shaxntanu/QUARK/docs/AI_SKILLS_REFERENCE.md

# AI skills and tool reference

This registry records the skills and specialized repositories named by the repository audit prompt, plus the tools actually used. A reference in the prompt does not mean that a skill was installed or used. Repository metadata was checked on 2026-11-02 where a source could be resolved.

| Skill or tool | Repository or source | Purpose and trigger | Availability and use in QUARK | Generated artifact, validation, or note |
|---|---|---|---|---|
| Anatomy | [wheresryan22/anatomy](https://github.com/wheresryan22/anatomy) | Build a spatial illustration when physical component relationships benefit from an isometric explanation. | Anatomy skill available in the Codex skill catalog; used for the existing system illustration. | `docs/anatomy/quark-system.svg`; XML parsed and links checked. It is not a PCB render. |
| Diagram Design | [cathrynlavery/diagram-design](https://github.com/cathrynlavery/diagram-design) | Create specialized diagrams when Mermaid or an existing figure does not communicate the structure well. | Skill available in the Codex catalog; no new diagram created in this audit because the existing Mermaid architecture and Anatomy figure cover the current system. | No new artifact. Repository relevance was reviewed; see [hardware workflow notes](research-notes.md). |
| Mermaid | [Mermaid documentation](https://mermaid.js.org/) | Describe small architecture and protocol diagrams as text when that is the simplest representation. | Used in `docs/architecture.md`; GitHub renders it. No separate Mermaid package is installed in the project. | Existing diagram retained; no duplicate diagram was created. |
| Taste Skill | [Leonxlnx/taste-skill](https://github.com/Leonxlnx/taste-skill) | Improve the visual quality of web interfaces and frontend layouts. | Upstream repository referenced. Local `design-taste-frontend` skill is available, but was not needed for this firmware and documentation work. | No frontend output. Not applicable to the repository's user-facing surface in this audit. |
| ManimGX | [academa-labs/manimgx](https://github.com/academa-labs/manimgx) and [documentation index](https://manimgx.academa.ai/llms.txt) | Create explanatory animation when change over time or motion is central to the explanation. | Not installed or used. A static system figure and Mermaid diagram are sufficient for this local hardware system. | No video or new dependency. |
| good-readme | [adewale/good-readme](https://github.com/adewale/good-readme) | Review project README structure and completeness. | Referenced by the prompt; not installed as a local skill or invoked directly. The repository README was reviewed and edited against repository evidence. | README is the artifact. The canonical verification command is documented there. |
| readme-writing | Prompt reference: `indubitably-ai/readme-writing` | Improve README composition and open-source navigation. | Repository lookup returned 404 on 2026-11-02. No official repository URL was verified and none is invented here. | Not installed or used. |
| JayRHa readme-generator | [JayRHa/agent-skills](https://github.com/JayRHa/agent-skills), skill name `readme-generator` | Draft README sections and project navigation when creating or revising a repository README. | Referenced by the prompt; not installed or invoked directly. | README edited from source and project evidence. |
| JayRHa technical-writer | [JayRHa/agent-skills](https://github.com/JayRHa/agent-skills), skill name `technical-writer` | Improve developer documentation and technical explanations. | Referenced by the prompt; not installed or invoked directly. | Documentation is checked for internal links and selected text policy. |
| riekelt technical-writer | [riekelt/technical-writer](https://github.com/riekelt/technical-writer) | Ground technical statements in repository evidence and label uncertainty. | Referenced by the prompt; not installed or invoked directly. | Applied as a documentation quality criterion, not as an installed tool. |
| Shpigford readme | Prompt reference: `Shpigford/readme` | Comprehensive README review. | Repository lookup returned 404 on 2026-11-02. No official repository URL was verified and none is invented here. | Not installed or used. |
| matt-riley writing-and-editing | Prompt reference: `matt-riley/writing-and-editing` | Editorial review for grammar and consistency. | Repository lookup returned 404 on 2026-11-02. No official repository URL was verified and none is invented here. | Not installed or used. |
| GitHub profile README | [boffti/github-profile-readme](https://github.com/boffti/github-profile-readme) | Conventions for a personal GitHub profile README. | Repository URL verified. Not applicable because QUARK is a project repository. | No artifact. |
| KiCad Happy | [aklofas/kicad-happy](https://github.com/aklofas/kicad-happy) | Reference for agent-assisted KiCad workflows. | Reviewed through Crawl4AI; not installed or copied into the project. | Findings summarized in [research notes](research-notes.md). |
| AI PCB Layout | [ChengminLi/AI-PCB-layout](https://github.com/ChengminLi/AI-PCB-layout) | Reference for PCB layout analysis in power-electronics contexts. | Reviewed through Crawl4AI; high-power switching practices were not applied to this low-speed carrier. | No new layout or thermal claim. See [research notes](research-notes.md). |
| KiCad MCP Pro | [oaslananka/kicad-mcp-pro](https://github.com/oaslananka/kicad-mcp-pro) | Reference for KiCad automation and CAD verification workflows. | Repository reviewed; no MCP server installed or used. | Native KiCad CLI results remain the CAD evidence. |
| KiStack | [BackplaneWorks/kistack](https://github.com/BackplaneWorks/kistack) | Reference for staged schematic, PCB, BOM, and manufacturing review. | The prompt URL redirects to this canonical repository. Reviewed through Crawl4AI; no source copied. | Existing outputs were inventoried; no new fabrication exports were created. |
| Circuit Skills | [punkfab/circuit-skills](https://github.com/punkfab/circuit-skills) | Reference for hardware-specific design checks beyond ERC and DRC. | Reviewed through Crawl4AI; not installed or copied. | No measured electrical claim was added. |
| Crawl4AI | [unclecode/crawl4ai](https://github.com/unclecode/crawl4ai) | Retrieve web pages for evidence-based engineering research. | Version 0.9.5 used from a temporary environment, not as a project dependency. Firecrawl was not used. | Source retrieval notes are in [research sources](research-sources.md). Some pages and a PDF timed out or returned anti-bot responses. |
| KiCad CLI | [KiCad CLI manual](https://docs.kicad.org/10.0/en/cli/cli.html) | Run schematic ERC and PCB DRC when KiCad source is changed or re-audited. | Version 10.0.7 was used for recorded CAD checks. | Results and ignored checks are in [verification](verification.md). |
| Arduino CLI | [Arduino CLI repository](https://github.com/arduino/arduino-cli) | Compile the ESP32-C3 sketch from a repeatable command or CI. | Version 1.5.1 used in hosted CI; not found on the local command path during this audit. | Firmware job compiles the `esp32:esp32:esp32c3:CDCOnBoot=cdc` target. |
| U8g2 | [U8g2 repository](https://github.com/olikraus/u8g2) | Drive the configured SH1106 128x64 OLED. | Version 2.36.19 installed in hosted firmware CI. | Compile-verified; exact OLED module remains unknown and hardware-unverified. |
| OpenAI documentation skill | Codex built-in skill `openai-docs`; [App Server docs](https://learn.chatgpt.com/docs/app-server) | Read current official OpenAI documentation for the Codex App Server interface. | Available in the Codex skill catalog and used to review the official interface documentation. | Source and constraints recorded in [research sources](research-sources.md). |
| Visualization skill | Codex built-in skill `visualize` | Create interactive visualizations when they materially improve understanding. | Available in the Codex skill catalog; not used because the hardware architecture is sufficiently covered by Mermaid and the static Anatomy figure. | No extra visualization artifact. |

Repository lookup failures are recorded as such. A skill being listed here is not a dependency, endorsement, or claim that its output was independently validated.

## Token-efficient agent stack

These five projects were supplied in the follow-up workflow prompt. Their GitHub repository URLs were checked through the GitHub API on 2026-11-02. No project was installed, configured, or integrated, so its installation instructions were not used. No measurable token or cost reduction is claimed.

| Project | Official repository | Availability in this agent session | Applied fallback |
|---|---|---|---|
| Ponytail | [DietrichGebert/ponytail](https://github.com/DietrichGebert/ponytail) | No matching active tool or command found. | Applied its minimal-solution review manually. No further code or dependencies were added after the audit passed. |
| Lean Coding Agent | [JeremyFaubert/lean-coding-agent-skill](https://github.com/JeremyFaubert/lean-coding-agent-skill) | No matching active skill or command found. | Used targeted file ranges, bounded outputs, and risk-based validation. |
| Serena | [oraios/serena](https://github.com/oraios/serena) | No Serena MCP tool or command found. | Used native exact search, Git diffs, and direct reads of relevant files. |
| skill-search | [sowhan/skill-search](https://github.com/sowhan/skill-search) | No matching active skill or command found. | Used the native skill catalog and loaded no unrelated skill descriptions. |
| Token Optimizer MCP | [ooples/token-optimizer-mcp](https://github.com/ooples/token-optimizer-mcp) | No matching active MCP tool found. | Bounded tool output and summarized relevant results. No large log or API payload required compression. |

The fallback policies come from the supplied prompt. They were applied without copying upstream code or installing new tooling into QUARK.
