shaxntanu/QUARK/docs/generated-artifacts.md

# Generated artifact provenance

This inventory records important checked-in outputs and the current Windows package build. It does not claim bit-for-bit reproducibility where the generator or export command is not deterministic or recorded.

| Artifact | Source or generator | Inputs | Generation method and tool | Validation and limitation |
|---|---|---|---|---|
| [System illustration](anatomy/quark-system.svg) | Anatomy skill, with repository architecture and hardware documentation as inputs | Current host, USB, controller, display, and control relationships | Static SVG was created for the audit. No standalone source generator or exact skill version is recorded. | XML parsed successfully and the image is linked from the README and architecture page. It is explanatory, not to scale or an assembly drawing. |
| ESP32-C3 firmware binary | `QUARK.ino` and installed Arduino packages | ESP32-C3 target and CDC-on-boot option | Arduino CLI 1.5.1, ESP32 core 3.3.10, U8g2 2.36.19; command in the README and CI workflow | CI compiles the source. The checked-in merged image and a previous local merged image had different SHA-256 values; the cause is not known. Do not treat them as identical builds. |
| KiCad schematic and PCB | `hardware/QUARK_SuperMini_Carrier/scripts/generate_schematic.py` and `generate_board.py` | Python generators, `pcbnew`, project-local symbols and footprints | Run each source generator in the KiCad Python environment. The board generator uses random UUIDs, so byte-for-byte regeneration is not deterministic. | Checked-in design was checked with KiCad CLI 10.0.7. Review the generated diff and ignored ERC/DRC checks before fabrication. |
| Gerbers, drill files, maps, and archive | KiCad project outputs under `hardware/QUARK_SuperMini_Carrier/fabrication/` | Checked-in schematic and PCB | The exact export command and KiCad export profile were not recorded. | Files are present and referenced by the hardware README. No fabricator inspection or board assembly is claimed. |
| BOM CSV | `hardware/QUARK_SuperMini_Carrier/BOM.csv` | Manually maintained board and off-board parts list | Edited as a project text file; no BOM export command is recorded. | Parts are mostly generic and exact MPNs are missing. See [hardware references](hardware-references.md). |
| KiCad preview PNGs and schematic PDF | KiCad project outputs in the `preview/` folder and carrier directory | Checked-in schematic and board | Exact export commands and tool versions for these files were not retained. | Existing outputs were inventoried; they are not new evidence of fabrication quality. |
| Windows executable | `quark.py`, `requirements.txt`, `requirements-build.txt`, `scripts/build_exe.ps1` | Python 3.12.10 Windows environment | `py -3.12 -m PyInstaller` through `scripts/build_exe.ps1`, PyInstaller 6.22.3 | Built successfully on 2026-11-02 at 9,840,202 bytes. `dist/QUARK.exe` is ignored and not committed. The build was not launched in a separate session. |

The Mermaid diagram in `architecture.md` is source text rendered by GitHub and is not a separately generated binary. Crawl4AI output was used only as research input and is not shipped with QUARK.
