shaxntanu/QUARK/docs/research-sources.md

# Research sources

This ledger records external sources that materially informed interface, tooling, and maintenance decisions. It does not claim that every cited reference was used to design an electrical limit or certify a standard.

| Source | URL | Type and authority | Version or date | Claim or decision supported | Notes |
|---|---|---|---|---|---|
| Codex App Server documentation | [OpenAI documentation](https://learn.chatgpt.com/docs/app-server) | Official product documentation | Accessed 2026-11-02 | The companion uses the local App Server JSON-RPC interface. The response reader now queues response messages and ignores unsolicited methods that it does not consume. | The interface and authentication guidance can change. This documents the local open-source companion, not a hosted service. No live account session was tested. |
| KiCad Command Line Interface manual | [KiCad 10 CLI manual](https://docs.kicad.org/10.0/en/cli/cli.html) | Official KiCad documentation | KiCad 10; checks used 10.0.7 | Documents the ERC and DRC commands used to check the supplied schematic and board. | The reports list ignored checks. See [verification](verification.md). |
| GitHub Actions secure use | [GitHub security guidance](https://docs.github.com/en/actions/reference/security/secure-use) | Official GitHub documentation | Accessed 2026-11-02 | Supports least-privilege workflow permissions and review of third-party actions. The workflow actions are pinned to immutable commit SHAs. | Guidance does not by itself establish that a pinned action is safe. Updates still need review. |
| GitHub Actions used by CI | [checkout source at the pinned commit](https://github.com/actions/checkout/tree/3d3c42e5aac5ba805825da76410c181273ba90b1), [setup-python source at the pinned commit](https://github.com/actions/setup-python/tree/6d4fd22b20465ccc0f7354476588e8df7c9ca0e0), [Arduino CLI setup source at the pinned commit](https://github.com/arduino/setup-arduino-cli/tree/81d310742121c928ea9c8bbd407b4217b432ae02) | Upstream source repositories and immutable revisions | Refs resolved from upstream release tags on 2026-11-02 | Establishes the exact action revisions used by the workflow. | Pinning prevents a tag move from silently changing workflow code; it does not replace action review. |
| Arduino ESP32 core release | [arduino-esp32 3.3.10 release](https://github.com/espressif/arduino-esp32/releases/tag/3.3.10) | Official upstream release record | 3.3.10 | Records the Arduino ESP32 core version selected by CI. | The release record is not a substitute for the compiler output in CI. |
| ESP32-C3 datasheet | [Espressif ESP32-C3 datasheet](https://documentation.espressif.com/esp32-c3_datasheet_en.pdf) | Official manufacturer document | Current document URL checked 2026-11-02 | Candidate primary reference for the ESP32-C3 SoC family. | Crawl4AI could not retrieve the PDF body during this audit. No numeric electrical constraint in this repository was newly justified from that document. The carrier uses a module, not a bare SoC. |
| Hardware workflow repositories | [Research notes](research-notes.md) | Maintainer-authored repositories, secondary engineering references | Crawled 2026-11-02 | Informed a proportionate review of existing KiCad source, BOM, fabrication exports, and ignored CAD checks. | These repositories were not installed as dependencies and their generators were not copied. |
| Crawl4AI | [Crawl4AI repository](https://github.com/unclecode/crawl4ai) | Open-source crawling tool | 0.9.5 in a temporary research environment | Used to retrieve selected project and official documentation pages for this audit. | GitHub raw pages and a vendor PDF timed out or triggered anti-bot behavior. Only successfully retrieved content informed the review. Crawl4AI is not a QUARK runtime or build dependency. |

## Retrieval notes

The Codex App Server guide was reviewed with the OpenAI documentation skill. Crawl4AI 0.9.5 was used for source retrieval, including the KiCad and hardware workflow review recorded in [research-notes.md](research-notes.md). The official KiCad manual, GitHub Actions security page, Arduino ESP32 release page, and selected GitHub repository metadata were reachable. Some GitHub raw pages and the Espressif PDF body could not be retrieved through Crawl4AI because of timeouts or anti-bot responses. The datasheet URL itself was reachable, but its contents were not treated as reviewed evidence.

## Research boundary

No academic novelty, comparative effectiveness, electrical certification, performance benchmark, or SDG impact claim is made. No external source was used to infer the exact manufacturer or revision of the SuperMini clone, OLED module, LEDs, piezo, or other generic BOM parts.
