shaxntanu/QUARK/hardware/QUARK_SuperMini_Carrier/preview/board_bottom.png

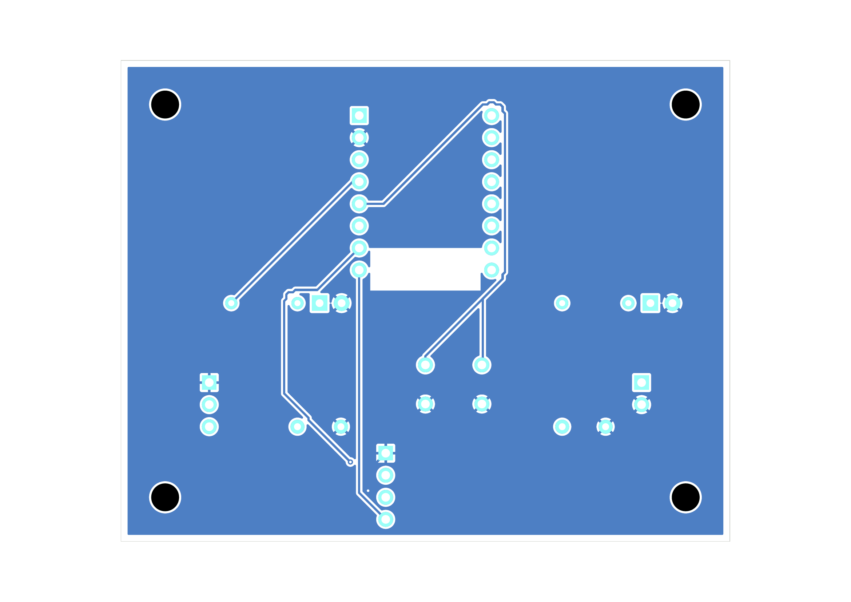
hardware/QUARK_SuperMini_Carrier/preview/board_bottom.png
