shaxntanu/QUARK/hardware/QUARK_SuperMini_Carrier/preview/board_top.png

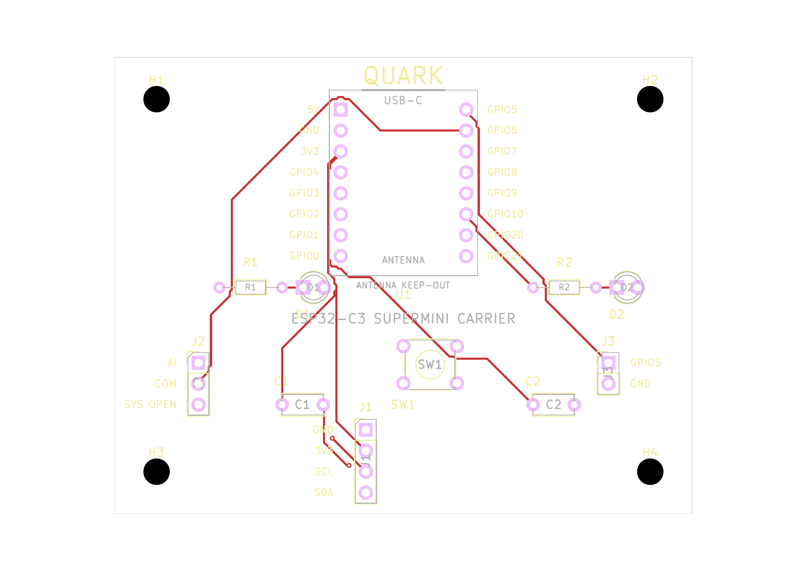
hardware/QUARK_SuperMini_Carrier/preview/board_top.png
