shaxntanu/QUARK/hardware/QUARK_SuperMini_Carrier/preview/schematic.png

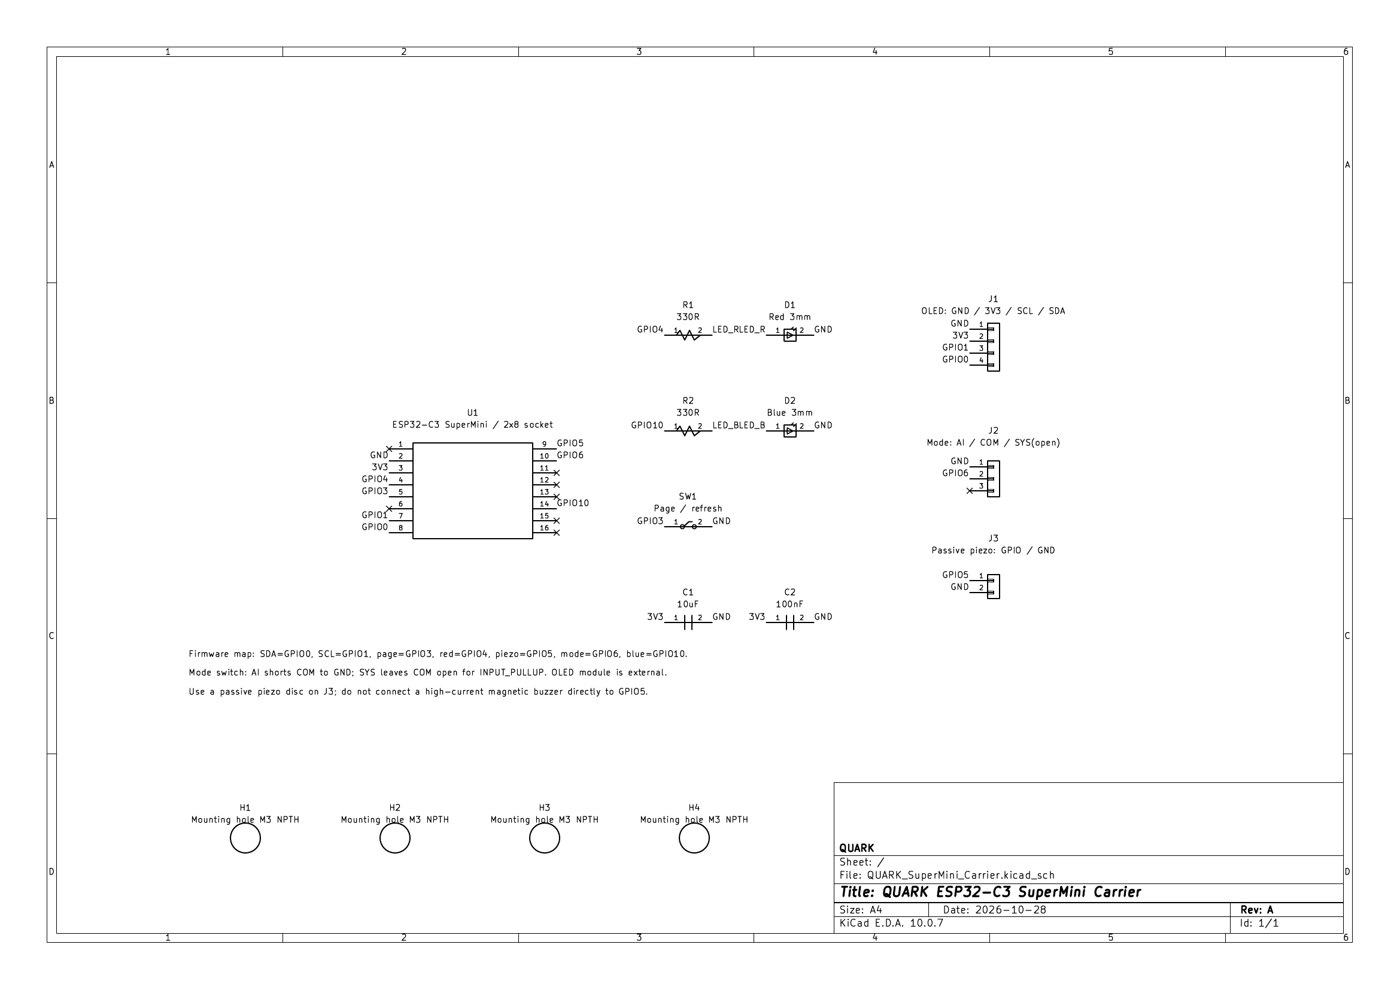
hardware/QUARK_SuperMini_Carrier/preview/schematic.png
