shaxntanu/QUARK/hardware/QUARK_SuperMini_Carrier/QUARK_SuperMini_Carrier_Schematic.pdf

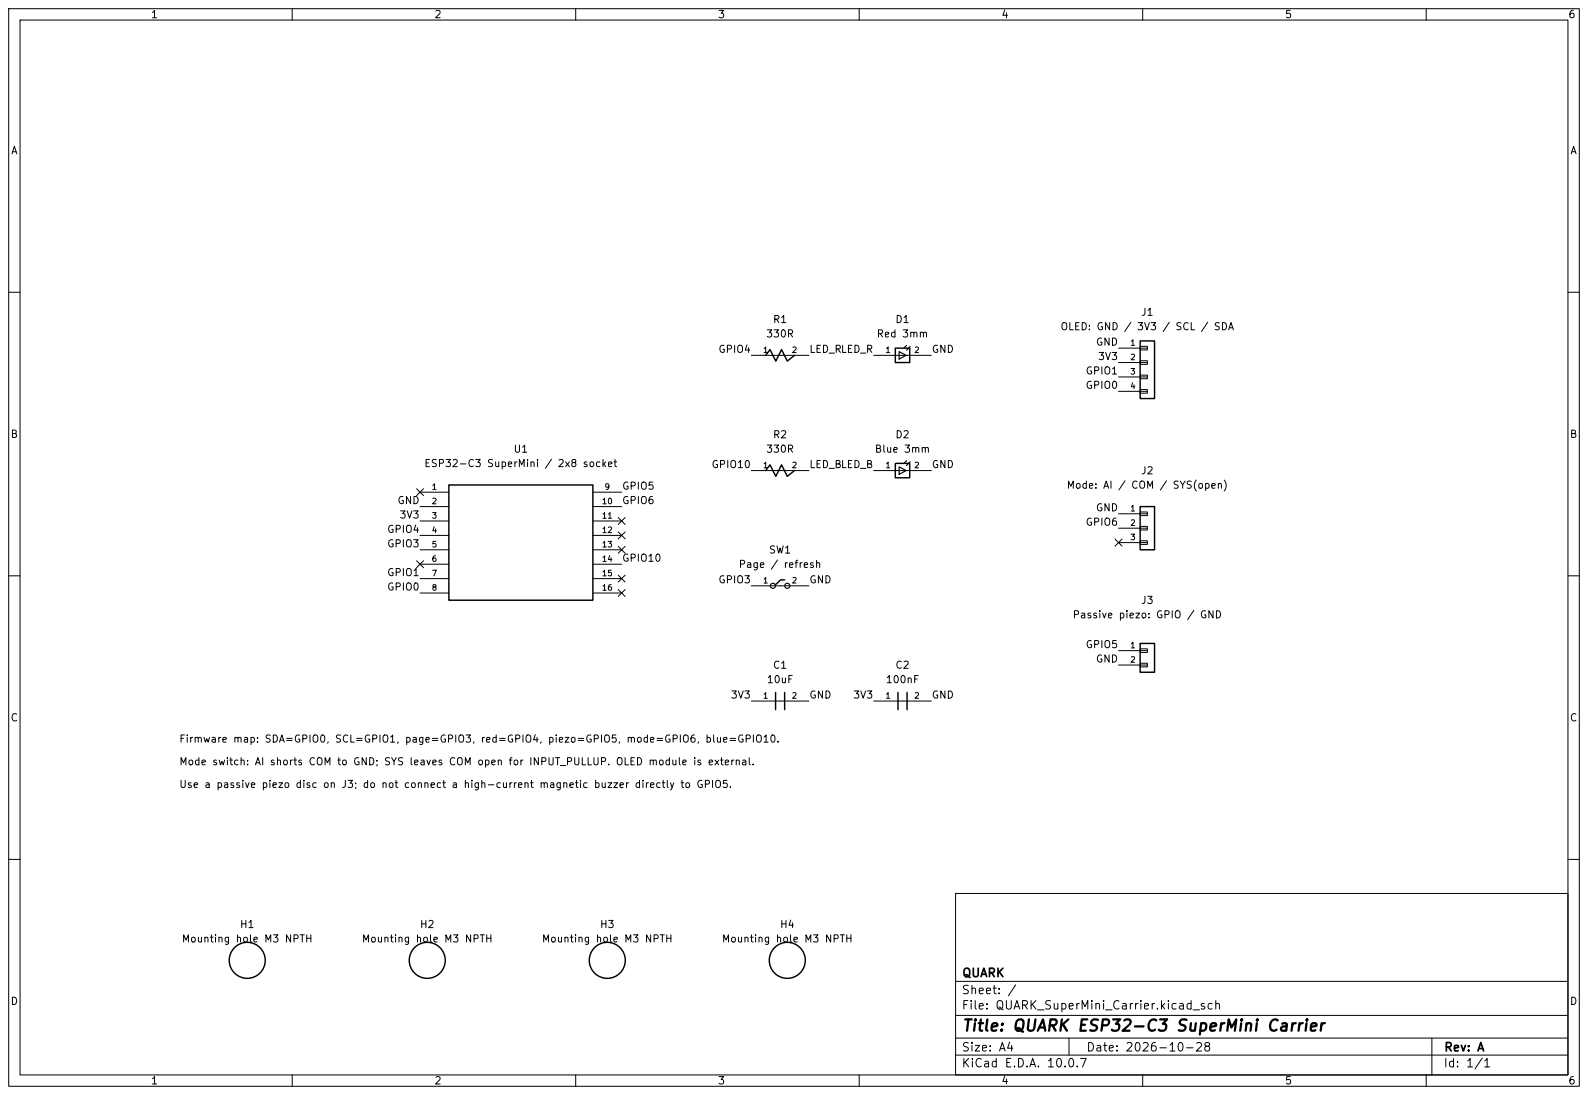
[picture p4: page 1]

4 J1 OLED: GND / 3V3 / SCL / SDA

GPIO4 Use a passive piezo disc on J3; do not connect a high-current magnetic buzzer directly to GPIO5. Firmware map: SDA=GPIO0, SCL=GPIO1, page=GPIO3, red=GPIO4, piezo=GPIO5, mode=GPIO6, blue=GPIO10. Mode switch: AI shorts COM to GND; SYS leaves COM open for INPUT_PULLUP. OLED module is external.

2 J3 Passive piezo: GPIO / GND

Size: A4 | Rev: A
KiCad E.D.A. 10.0.7 | Id: 1/1
