shaxntanu/QUARK/hardware/QUARK_SuperMini_Carrier/QUARK_SuperMini_Carrier.kicad_pcb

## KiCad design hardware/QUARK_SuperMini_Carrier/QUARK_SuperMini_Carrier.kicad_pcb (2026-10-28)

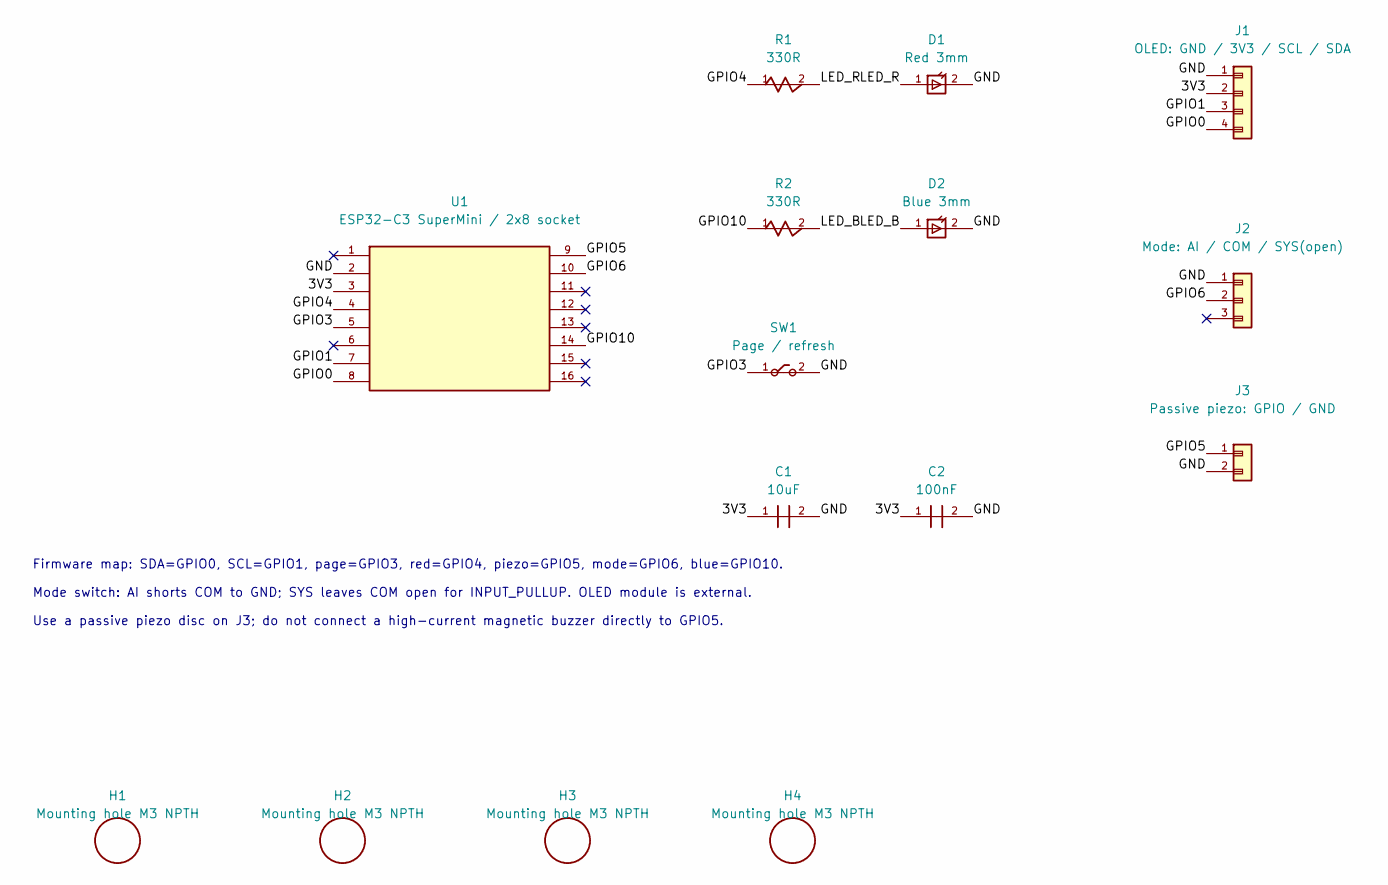
[picture p5: schematic QUARK_SuperMini_Carrier.kicad_sch, QUARK ESP32-C3 SuperMini Carrier]

Parts:
C1: 10uF; C_Disc_D5.0mm_W2.5mm_P5.00mm
C2: 100nF; C_Disc_D5.0mm_W2.5mm_P5.00mm
D1: Red 3mm; LED_D3.0mm
D2: Blue 3mm; LED_D3.0mm
H1, H2, H3, H4: Mounting hole M3 NPTH; MountingHole_3.2mm_M3
J1: OLED: GND / 3V3 / SCL / SDA; PinHeader_1x04_P2.54mm_Vertical
J2: Mode: AI / COM / SYS(open); PinHeader_1x03_P2.54mm_Vertical
J3: Passive piezo: GPIO / GND; PinHeader_1x02_P2.54mm_Vertical
R1, R2: 330R; R_Axial_DIN0204_L3.6mm_D1.6mm_P7.62mm_Horizontal
SW1: Page / refresh; SW_TH_Tactile_Omron_B3F-100x
U1: ESP32-C3 SuperMini / 2x8 socket; ESP32C3_SuperMini_Socket_2x8

Connections:
/3V3: C1.1, C2.1, J1.2, U1.3 (3V3)
/GND: C1.2, C2.2, D1.2 (K), D2.2 (K), J1.1, J2.1, J3.2, SW1.2, U1.2 (GND)
/GPIO0: J1.4, U1.8 (GPIO0)
/GPIO1: J1.3, U1.7 (GPIO1)
/GPIO3: SW1.1, U1.5 (GPIO3)
/GPIO4: R1.1, U1.4 (GPIO4)
/GPIO5: J3.1, U1.9 (GPIO5)
/GPIO6: J2.2, U1.10 (GPIO6)
/GPIO10: R2.1, U1.14 (GPIO10)
/LED_B: D2.1 (A), R2.2
/LED_R: D1.1 (A), R1.2

Notes on the sheet:
Firmware map: SDA=GPIO0, SCL=GPIO1, page=GPIO3, red=GPIO4, piezo=GPIO5, mode=GPIO6, blue=GPIO10.
Mode switch: AI shorts COM to GND; SYS leaves COM open for INPUT_PULLUP. OLED module is external.
Use a passive piezo disc on J3; do not connect a high-current magnetic buzzer directly to GPIO5.

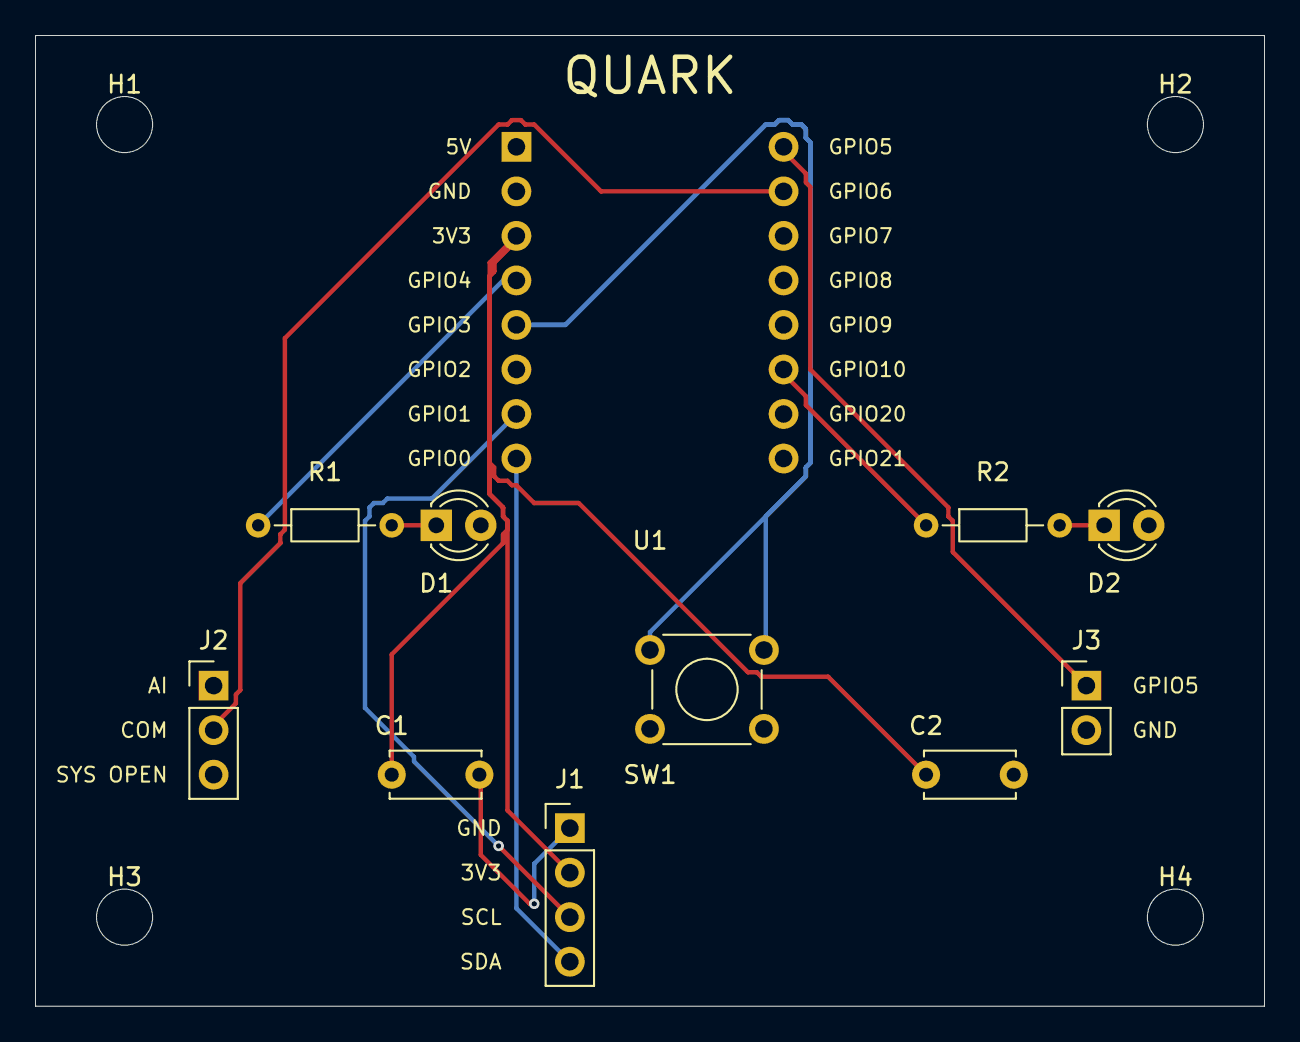
[picture p6: board QUARK_SuperMini_Carrier.kicad_pcb from above]

Board: 2 copper layers, 70.1 x 55.4 mm, 15 parts (0 on the bottom side), 11 nets.
