shaxntanu/QUARK/(commit log)

2026-10-28 fix(firmware): prevent metric value overlap
    [QUARK.ino]
2026-10-28 feat(hardware): add ESP32-C3 SuperMini carrier design
    [BOM.csv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]
2026-10-28 fix(firmware): silence buzzer between tones
    [QUARK.ino]
2026-11-02 fix: bound telemetry packets to serial frame
    [quark.py]
2026-11-02 ci: pin dependencies and build firmware
2026-11-02 ci: pin stable firmware runner
2026-11-02 fix: harden serial protocol boundaries
    [QUARK.ino, quark.py]
2026-11-02 security: pin GitHub Actions to verified SHAs
